kryo-77/not-a-block/CAD/nb_stl.stl

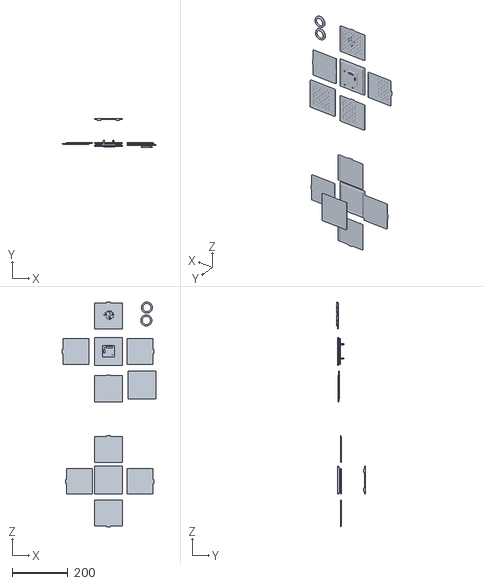
[picture p11: CAD file, 2026-10-25]
CAD/nb_stl.stl
336.3 x 103.0 x 803.7
