kryo-77/not-a-block/PCB/3d_model/notablock.step

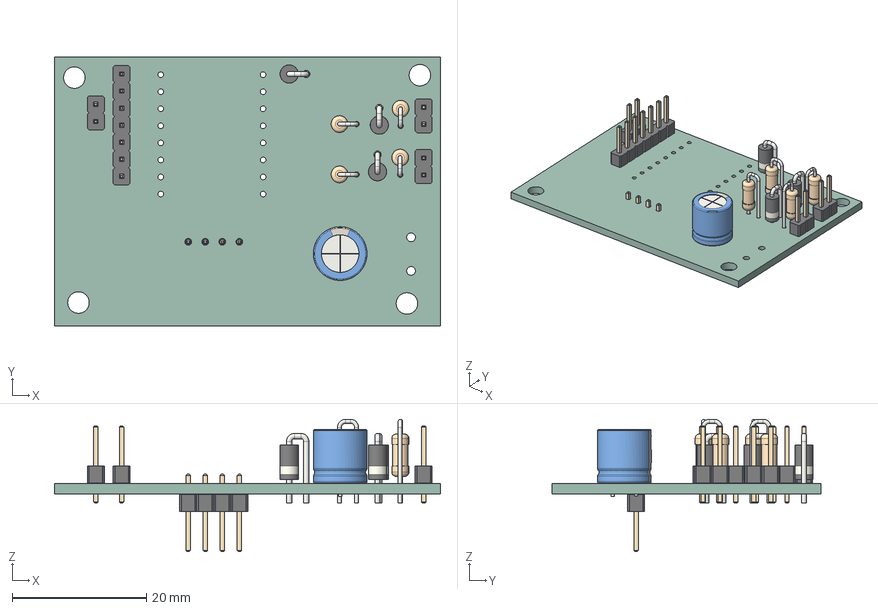
[picture p12: CAD file, 2026-10-24]
PCB/3d_model/notablock.step
57.5 x 40.0 x 19.7 mm
PinHeader_1x07_P254mm_Vertical
R_Axial_DIN0207_L63mm_D25mm_P254mm_Vertical x 4
D_DO-41_SOD81_P2.54mm_Vertical_AnodeUp x 3
PinHeader_1x02_P254mm_Vertical x 3
CP_Radial_D80mm_P350mm
PinHeader_1x04_P254mm_Vertical
not1AFB_PCB
