kryo-77/not-a-block/PCB/footprints_ext/ESP32-C3_SUPERMINI_TH/ESP32-C3_SUPERMINI_TH.step

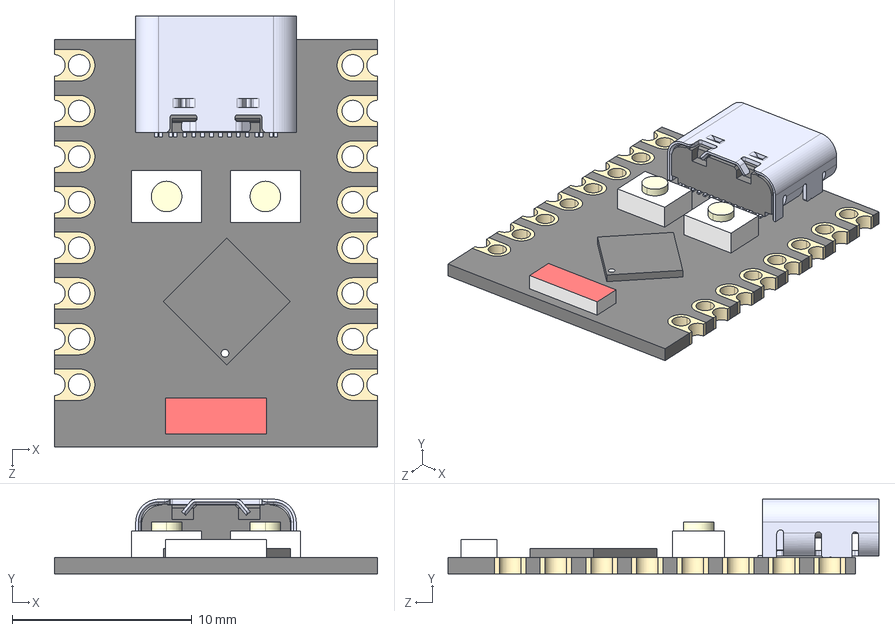
[picture p13: CAD file, 2026-10-25]
PCB/footprints_ext/ESP32-C3_SUPERMINI_TH/ESP32-C3_SUPERMINI_TH.step
18.0 x 4.16 x 24.0 mm
Board c3mini
USB C
components (other)^ESP32-C3 SuperMini
