kryo-77/not-a-block/(list of files, cad)

Other CAD files:
CAD/noteblock.f3d
