kryo-77/not-a-block/PCB/notablock.kicad_pcb

## KiCad design PCB/notablock.kicad_pcb (2026-10-24)

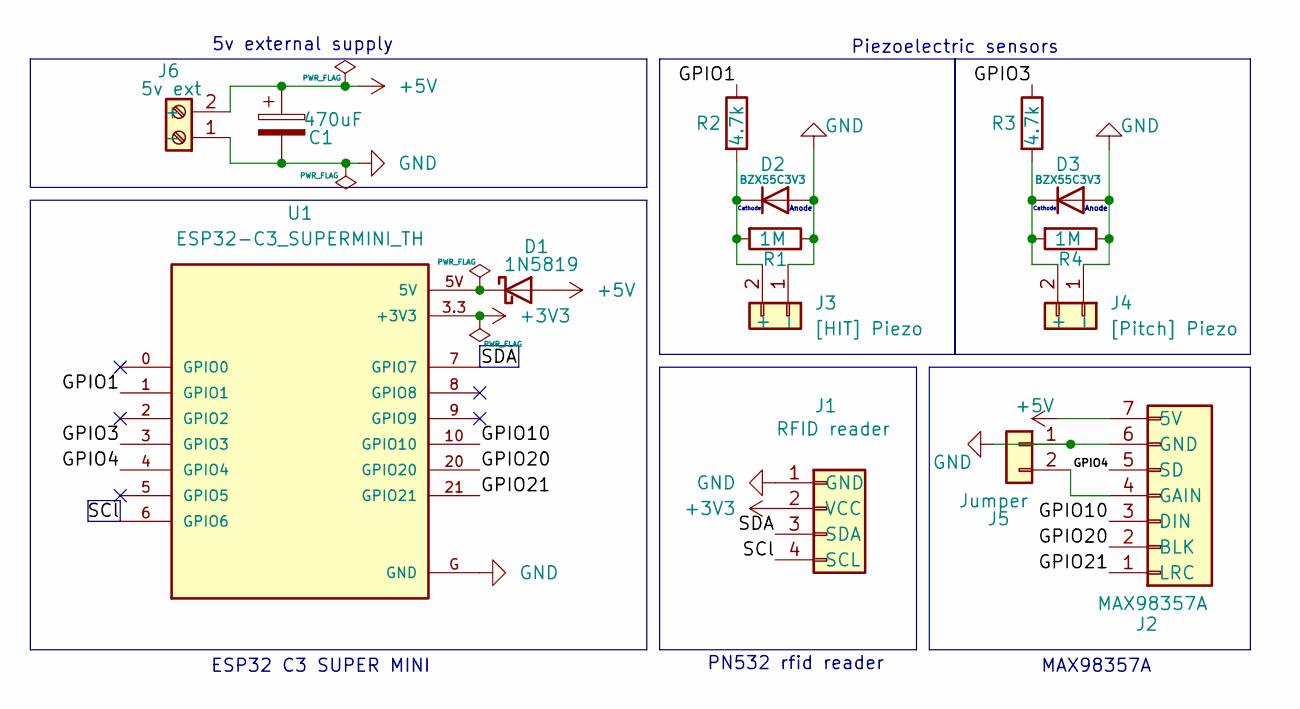
[picture p14: schematic notablock.kicad_sch]

Parts:
C1: 470uF; CP_Radial_D8.0mm_P3.50mm
D1: 1N5819; D_DO-41_SOD81_P2.54mm_Vertical_AnodeUp
D2, D3: BZX55C3V3; D_DO-41_SOD81_P2.54mm_Vertical_AnodeUp
J1: RFID reader; PinHeader_1x04_P2.54mm_Vertical
J2: MAX98357A; PinHeader_1x07_P2.54mm_Vertical
J3: [HIT] Piezo; PinHeader_1x02_P2.54mm_Vertical
J4: [Pitch] Piezo; PinHeader_1x02_P2.54mm_Vertical
J5: Jumper; PinHeader_1x02_P2.54mm_Vertical
J6: 5v ext; TerminalBlock_MaiXu_MX126-5.0-02P_1x02_P5.00mm
R1, R4: 1M; R_Axial_DIN0207_L6.3mm_D2.5mm_P2.54mm_Vertical
R2, R3: 4.7k; R_Axial_DIN0207_L6.3mm_D2.5mm_P2.54mm_Vertical
U1: ESP32-C3_SUPERMINI_TH; MODULE_ESP32-C3_SUPERMINI_TH

Connections:
+3V3: J1.2 (VCC), U1.3.3 (+3V3)
+5V: C1.1, D1.2 (A), J2.7 (5V), J6.2 (+)
/GPIO1: R2.1, U1.1 (GPIO1)
/GPIO3: R3.1, U1.3 (GPIO3)
/GPIO4: J2.5 (SD), U1.4 (GPIO4)
/GPIO10: J2.3 (DIN), U1.10 (GPIO10)
/GPIO20: J2.2 (BLK), U1.20 (GPIO20)
/GPIO21: J2.1 (LRC), U1.21 (GPIO21)
/SCl: J1.4 (SCL), U1.6 (GPIO6)
/SDA: J1.3 (SDA), U1.7 (GPIO7)
GND: C1.2, D2.2 (A), D3.2 (A), J1.1 (GND), J2.6 (GND), J3.1 (-), J4.1 (-), J5.1, J6.1 (-), R1.1, R4.1, U1.G (GND)
unnamed: D1.1 (K), U1.5V
unnamed: D2.1 (K), J3.2 (+), R1.2, R2.2
unnamed: D3.1 (K), J4.2 (+), R3.2, R4.2
unnamed: J2.4 (GAIN), J5.2

Notes on the sheet:
Anode
Piezoelectric sensors
Cathode
5v external supply
ESP32 C3 SUPER MINI
PN532 rfid reader
MAX98357A

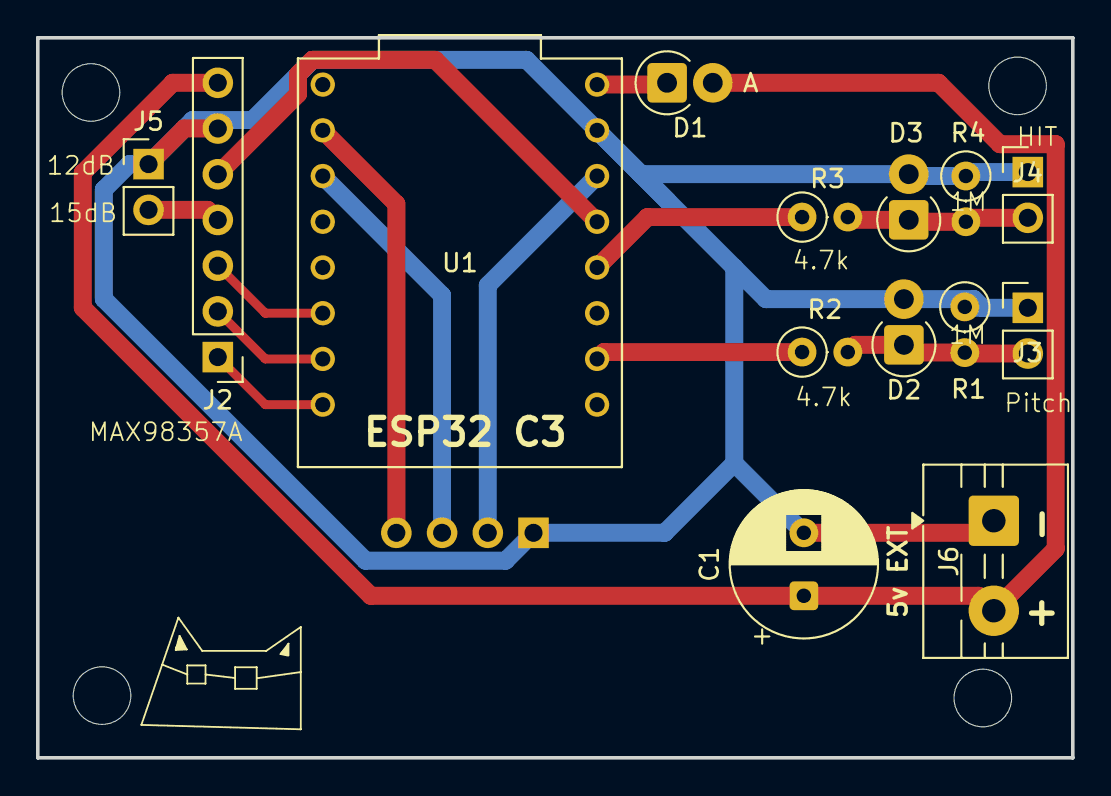
[picture p15: board notablock.kicad_pcb from above]

Board: 2 copper layers, 57.5 x 40.0 mm, 15 parts (1 on the bottom side), 15 nets.
