kryo-77/not-a-block/(commit log)

2026-10-24 added pcb files
    [nb_stl.stl, notablock.kicad_pcb, notablock.kicad_sch, notablock.step, noteblock.f3d]
2026-10-25 PCB updates
    [ESP32-C3_SUPERMINI_TH.step]
